Horticulture-project/Soilsensor-PCB/case/b_parasite_case_high_airflow.3mf

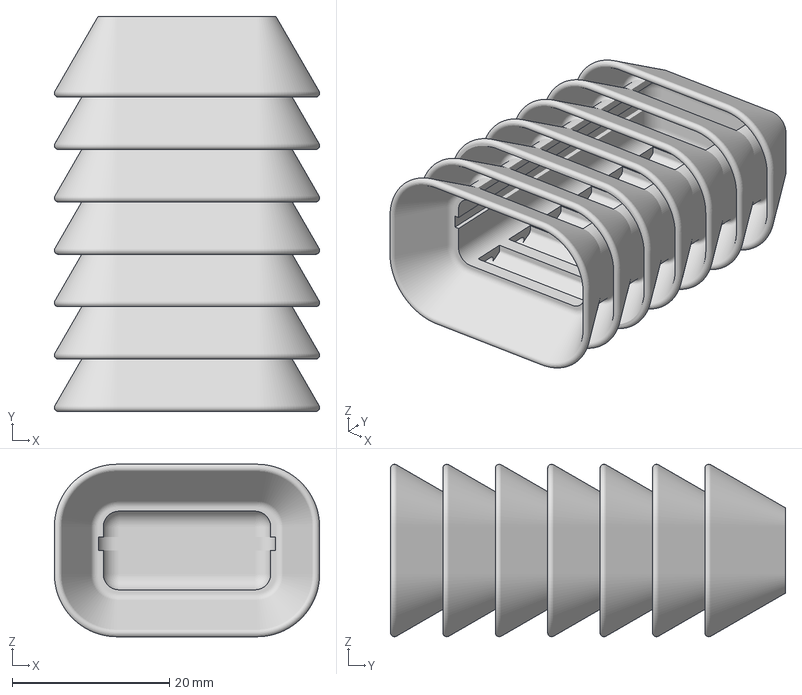
[picture p1: CAD file, 2022-11-05]
case/b_parasite_case_high_airflow.3mf
33.8 x 50.3 x 22.0 mm
