Horticulture-project/Soilsensor-PCB/(list of files, cad)

Other CAD files:
case/b_parasite_case_high_airflow.stl
