Horticulture-project/Soilsensor-PCB/kicad/parasite.kicad_pcb

## KiCad design kicad/parasite.kicad_pcb (2022-09-30)

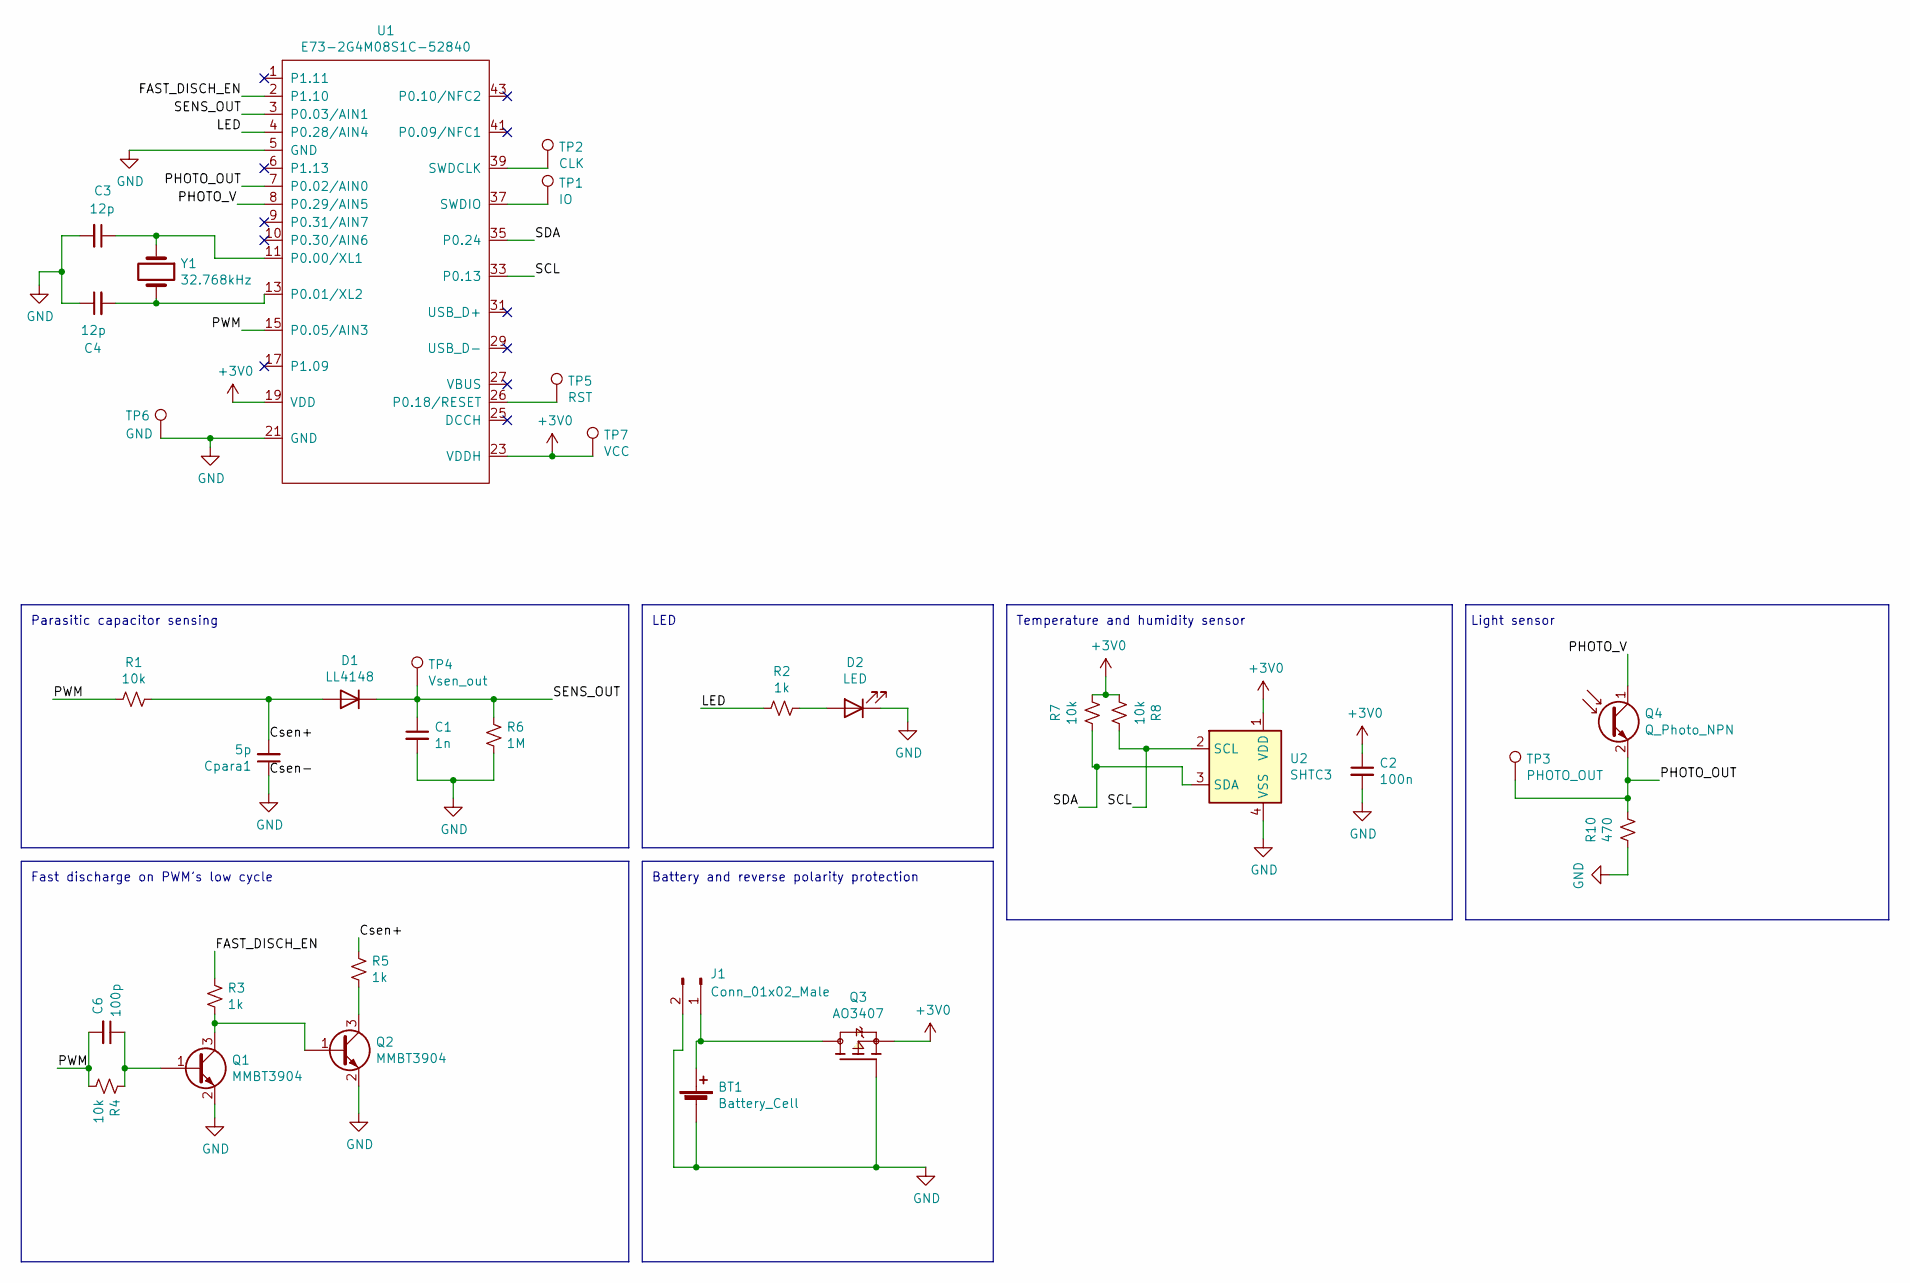
[picture p2: schematic parasite.kicad_sch, b-parasite]

Parts:
BT1: Battery_Cell; BatteryHolder_Keystone_3002_1x2032
C1: 1n; C_0402_1005Metric; LCSC C1523
C2: 100n; C_0402_1005Metric; LCSC C1525
C3, C4: 12p; C_0402_1005Metric; LCSC C1547
C6: 100p; C_0402_1005Metric; LCSC C1546
Cpara1: 5p; C_0805_2012Metric
D1: LL4148; D_MiniMELF; LCSC C9808
D2: LED; LED_0603_1608Metric; LCSC C2286
J1: Conn_01x02_Male; Molex_PicoBlade_53261-0271_1x02-1MP_P1.25mm_Horizontal
Q1, Q2: MMBT3904; SOT-23; LCSC C20526
Q3: AO3407; SOT-23; LCSC C181093
Q4: Q_Photo_NPN; TR8; LCSC C146233
R1, R4, R7, R8: 10k; R_0402_1005Metric; LCSC C25744
R2, R3, R5: 1k; R_0402_1005Metric; LCSC C11702
R6: 1M; R_0402_1005Metric; LCSC C26083
R10: 470; R_0402_1005Metric; LCSC C25117
TP1: IO; TestPoint_Pad_D1.0mm
TP2: CLK; TestPoint_Pad_D1.0mm
TP3: PHOTO_OUT; TestPoint_Pad_D1.0mm
TP4: Vsen_out; TestPoint_Pad_D1.0mm
TP5: RST; TestPoint_Pad_D1.0mm
TP6: GND; TestPoint_Pad_D1.0mm
TP7: VCC; TestPoint_Pad_D1.0mm
U1: E73-2G4M08S1C-52840; LCSC C356849
U2: SHTC3; Sensirion_DFN-4-1EP_2x2mm_P1mm_EP0.7x1.6mm; LCSC C194656
Y1: 32.768kHz; Crystal_SMD_3215-2Pin_3.2x1.5mm; LCSC C32346

Connections:
+3V0: C2.1, Q3.2, R7.2, R8.1, TP7.1, U1.19 (VDD), U1.23 (VDDH), U2.1 (VDD)
/Csen+: Cpara1.2, D1.2 (A), R1.2, R5.1
/FAST_DISCH_EN: R3.1, U1.2 (P1.10)
/LED: R2.1, U1.4 (P0.28/AIN4)
/PHOTO_OUT: Q4.2 (E), R10.2, TP3.1, U1.7 (P0.02/AIN0)
/PHOTO_V: Q4.1 (C), U1.8 (P0.29/AIN5)
/PWM: C6.2, R1.1, R4.2, U1.15 (P0.05/AIN3)
/SCL: R8.2, U1.33 (P0.13), U2.2 (SCL)
/SDA: R7.1, U1.35 (P0.24), U2.3 (SDA)
/SENS_OUT: C1.1, D1.1 (K), R6.1, TP4.1, U1.3 (P0.03/AIN1)
GND: BT1.2 (-), C1.2, C2.2, C3.2, C4.1, Cpara1.1, D2.1 (K), J1.2, J1.MP, Q1.2 (E), Q2.2 (E), Q3.1, R6.2, R10.1, TP6.1, U1.5 (GND), U1.21 (GND), U2.4 (VSS)
unnamed: BT1.1 (+), J1.1, Q3.3
unnamed: C3.1, U1.11 (P0.00/XL1), Y1.1
unnamed: C4.2, U1.13 (P0.01/XL2), Y1.2
unnamed: C6.1, Q1.1 (B), R4.1
unnamed: D2.2 (A), R2.2
unnamed: Q1.3 (C), Q2.1 (B), R3.2
unnamed: Q2.3 (C), R5.2
unnamed: TP1.1, U1.37 (SWDIO)
unnamed: TP2.1, U1.39 (SWDCLK)
unnamed: TP5.1, U1.26 (P0.18/RESET)

Notes on the sheet:
Light sensor
Battery and reverse polarity protection
Temperature and humidity sensor
Parasitic capacitor sensing
LED
Fast discharge on PWM’s low cycle

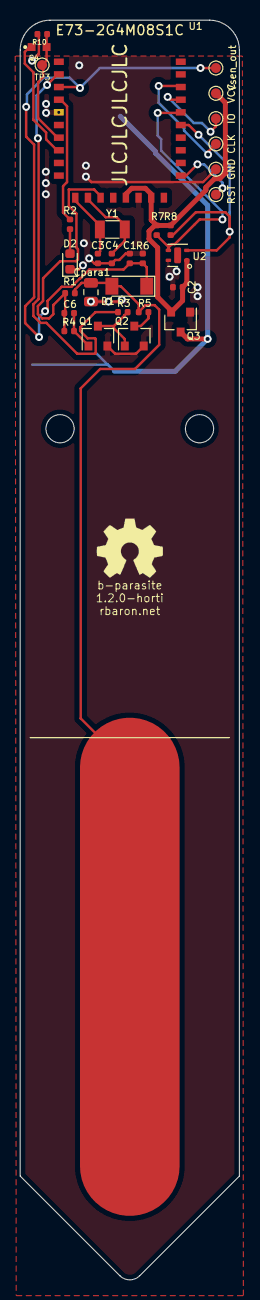
[picture p3: board parasite.kicad_pcb from above]

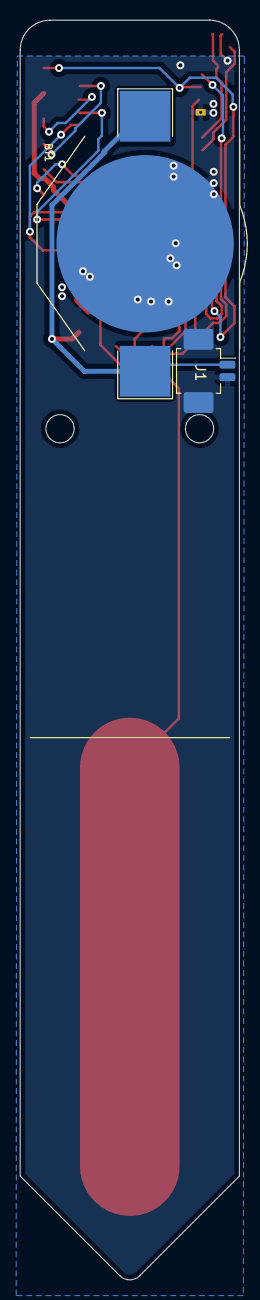
[picture p4: board parasite.kicad_pcb from below]

Board: 2 copper layers, 22.0 x 126.4 mm, 33 parts (2 on the bottom side), 21 nets.
