Horticulture-project/Soilsensor-PCB/(commit log)

2022-09-30 added picoblade connector
    [parasite.kicad_pcb, parasite.kicad_sch]
2022-11-05 Pulling new changes (#1)
    * high airflow case design stl and 3mf files
    * Added mac converter class for easy reading of mac address from microcontroller.
    * Added script for facilitating flashing procedures with pyocd.
    * Changed use of memory addresses in mac address reader to hex representation.
    * Added requirements file for python environment setup.
    * Simplified the cli of flashing scripts.
    * Moving the flashing files to different subfolder for better discoverability.
    * Added basic readme for flashing based on issue #67.
    * Clarified mac address code so that it will be clearer what it contains (static device mac).
    * Final cosmetic changes in flashing code to improve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
    [b_parasite_case_high_airflow.3mf, b_parasite_case_high_airflow.stl]
